nmarks99/reaction-wheel/README.md

# Reaction Wheel Project
This project was started to fullfil the competition requiements of the Midwest High Power Rocketry Competition in 2019-2020, which involved controlling the roll axis of a high power rocket.
