nmarks99/reaction-wheel/RW CAD/motor and sensor assem.SLDASM

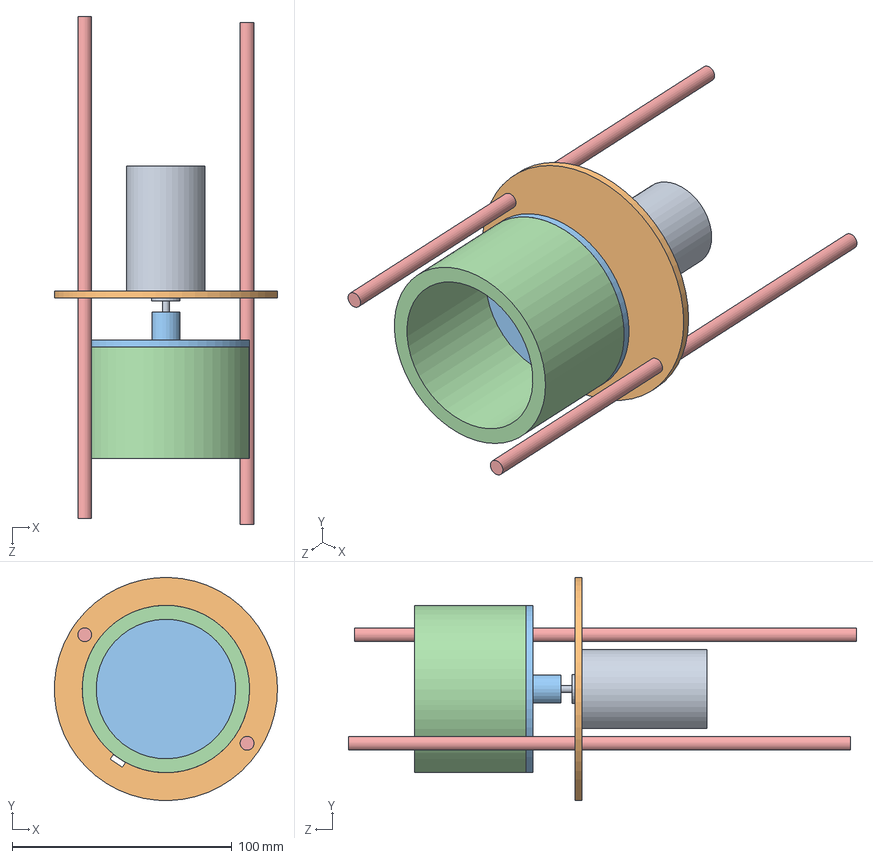
[picture p16: CAD file, 2021-04-07, last stored version]
RW CAD/motor and sensor assem.SLDASM
101.5 x 101.6 x 231.3 mm
mabuchi motor
motor disk
motor shaft coupler
rotating mass
0.25-20 threaded rod x 2
