nmarks99/reaction-wheel/RW CAD/0.25-20 threaded rod.SLDPRT

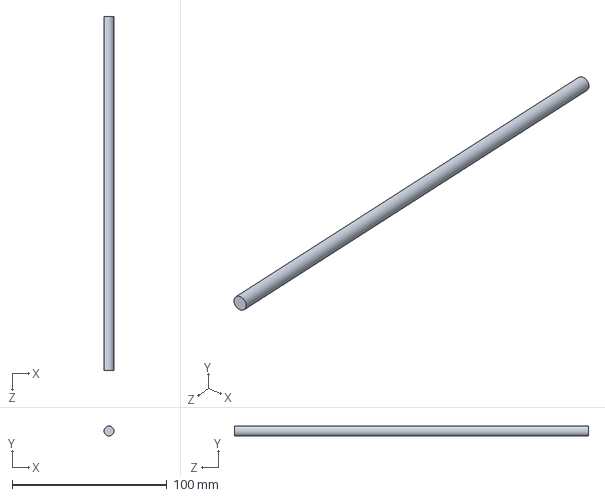
[picture p17: CAD file, 2021-04-07, last stored version]
RW CAD/0.25-20 threaded rod.SLDPRT
6.35 x 6.35 x 228.6 mm
