nmarks99/reaction-wheel/RW CAD/photo interruptor.SLDPRT

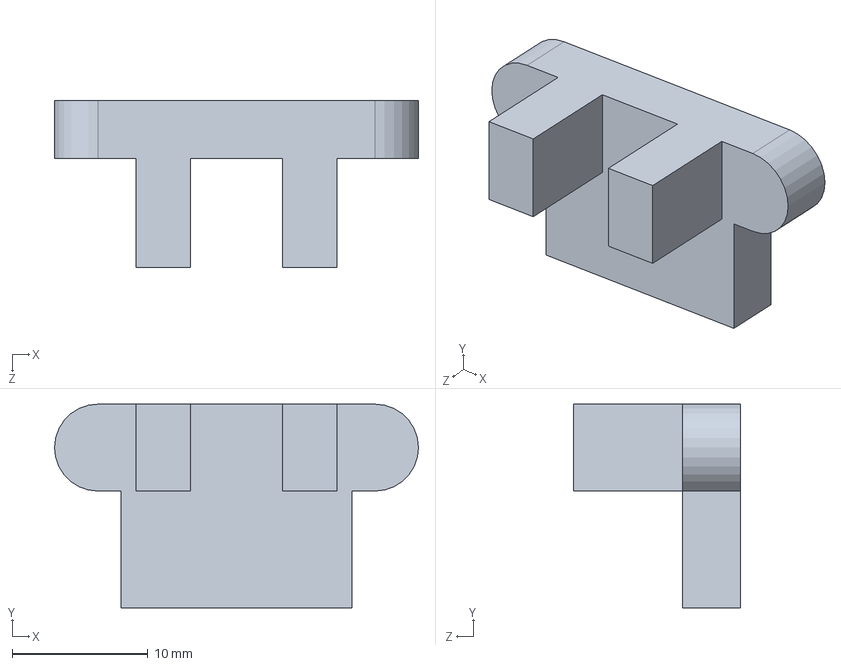
[picture p18: CAD file, 2021-04-07, last stored version]
RW CAD/photo interruptor.SLDPRT
26.8 x 15.0 x 12.3 mm
