nmarks99/reaction-wheel/RW CAD/motor holder.SLDPRT

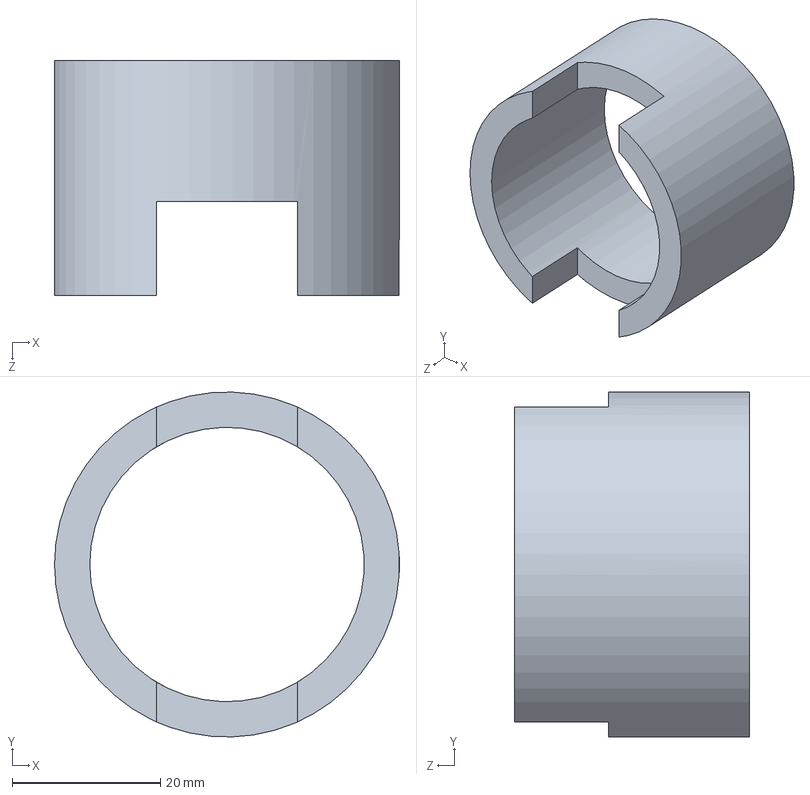
[picture p19: CAD file, 2021-04-07, last stored version]
RW CAD/motor holder.SLDPRT
46.5 x 46.5 x 31.8 mm
