nmarks99/reaction-wheel/RW CAD/motorholder top plate.STL

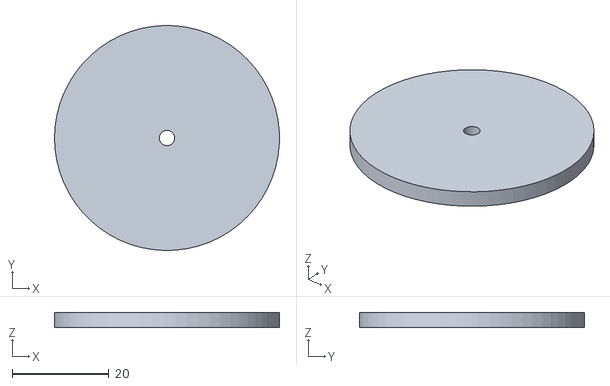
[picture p20: CAD file, 2021-04-07, last stored version]
RW CAD/motorholder top plate.STL
46.5 x 46.5 x 3.17
