nmarks99/reaction-wheel/RW CAD/electronics tray.STL

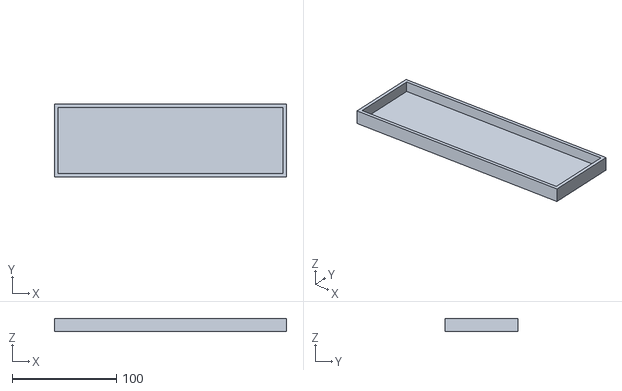
[picture p21: CAD file, 2021-04-07, last stored version]
RW CAD/electronics tray.STL
222.2 x 69.8 x 12.7
