nmarks99/reaction-wheel/RW CAD/motor disk.SLDPRT

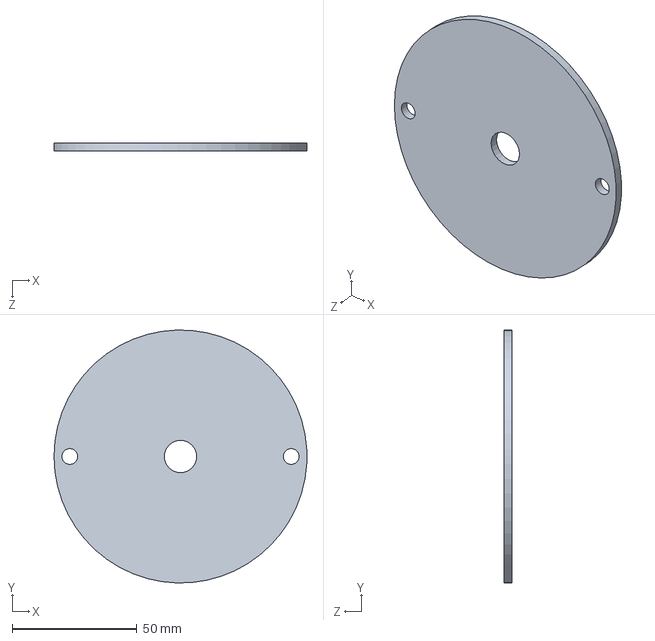
[picture p22: CAD file, 2021-04-07, last stored version]
RW CAD/motor disk.SLDPRT
101.6 x 101.6 x 3.17 mm
