nmarks99/reaction-wheel/RW CAD/electronics tray bottom.SLDPRT

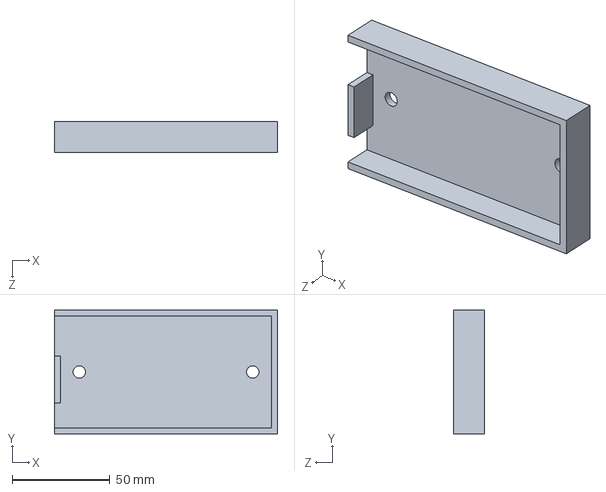
[picture p23: CAD file, 2021-04-07, last stored version]
RW CAD/electronics tray bottom.SLDPRT
114.3 x 63.5 x 15.9 mm
