nmarks99/reaction-wheel/RW CAD/sensor holder.SLDPRT

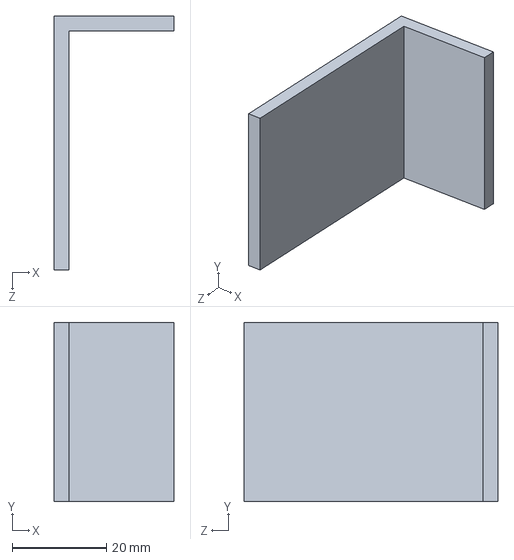
[picture p24: CAD file, 2021-04-07, last stored version]
RW CAD/sensor holder.SLDPRT
25.4 x 38.1 x 54.0 mm
