nmarks99/reaction-wheel/RW CAD/centeringring.STL

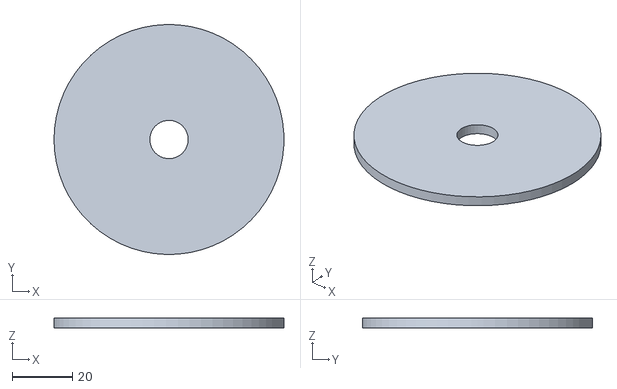
[picture p25: CAD file, 2021-04-07, last stored version]
RW CAD/centeringring.STL
76.2 x 76.2 x 3.17
