nmarks99/reaction-wheel/RW CAD/motor shaft coupler.SLDPRT

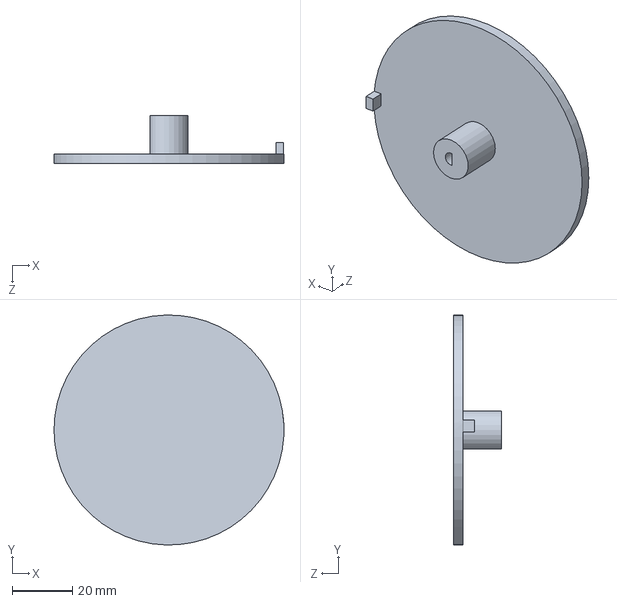
[picture p26: CAD file, 2021-04-07, last stored version]
RW CAD/motor shaft coupler.SLDPRT
76.2 x 76.2 x 15.9 mm
