nmarks99/reaction-wheel/RW CAD/rotating mass.SLDPRT

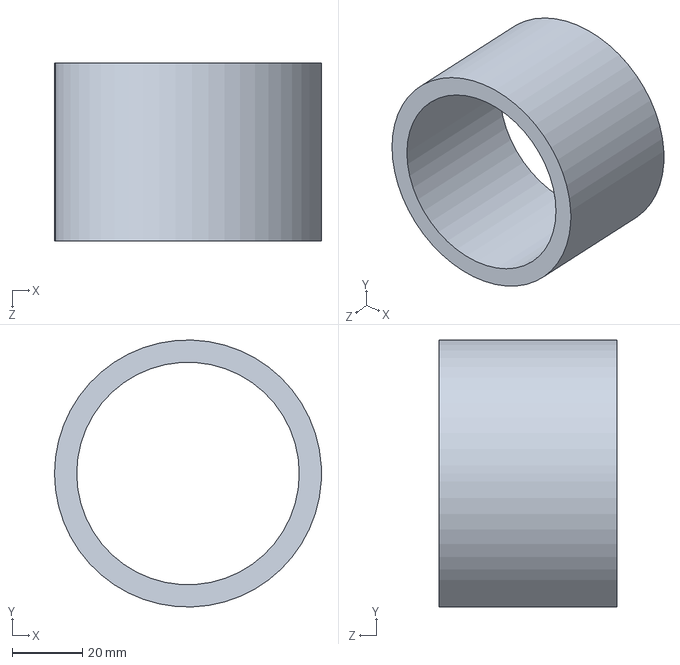
[picture p27: CAD file, 2021-04-07, last stored version]
RW CAD/rotating mass.SLDPRT
76.2 x 76.2 x 50.8 mm
