nmarks99/reaction-wheel/RW CAD/mabuchi motor.SLDPRT

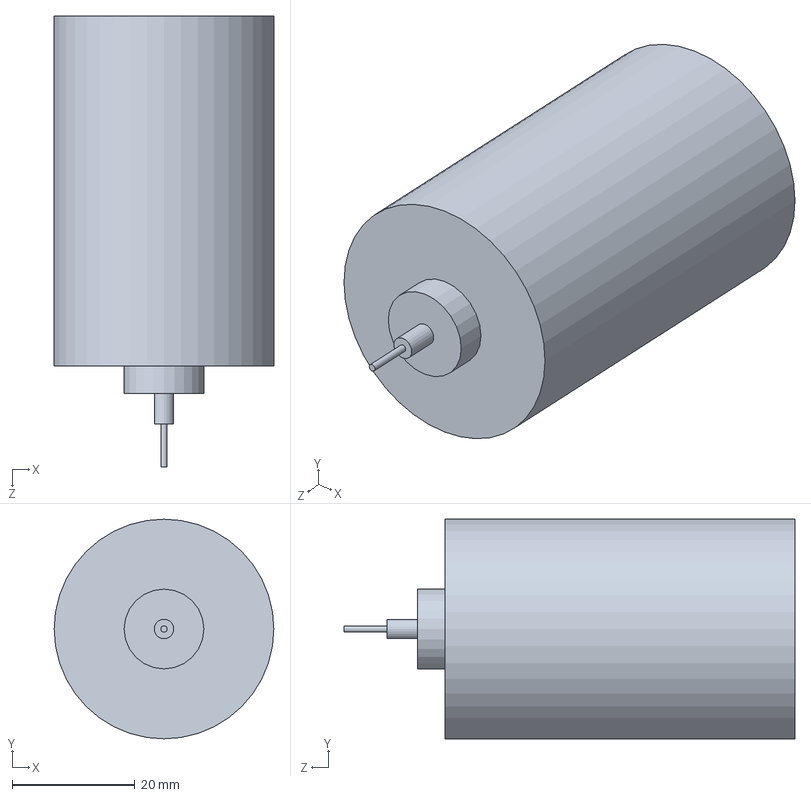
[picture p28: CAD file, 2021-04-07, last stored version]
RW CAD/mabuchi motor.SLDPRT
35.8 x 35.8 x 73.5 mm
