nmarks99/reaction-wheel/(list of files, cad)

Other CAD files:
RW CAD/electronics tray top.SLDPRT
RW CAD/centering.SLDPRT
RW CAD/electronics tray bottom.SLDDRW
RW CAD/electronics tray bottom.STL
RW CAD/electronics tray top.SLDDRW
RW CAD/electronics tray top.STL
RW CAD/motor disk.SLDDRW
RW CAD/motor disk.STL
RW CAD/motor holder.STL
RW CAD/motor shaft coupler.STL
RW CAD/sensor holder.STL
