nmarks99/reaction-wheel/Analysis/results_plots/data1.jpg

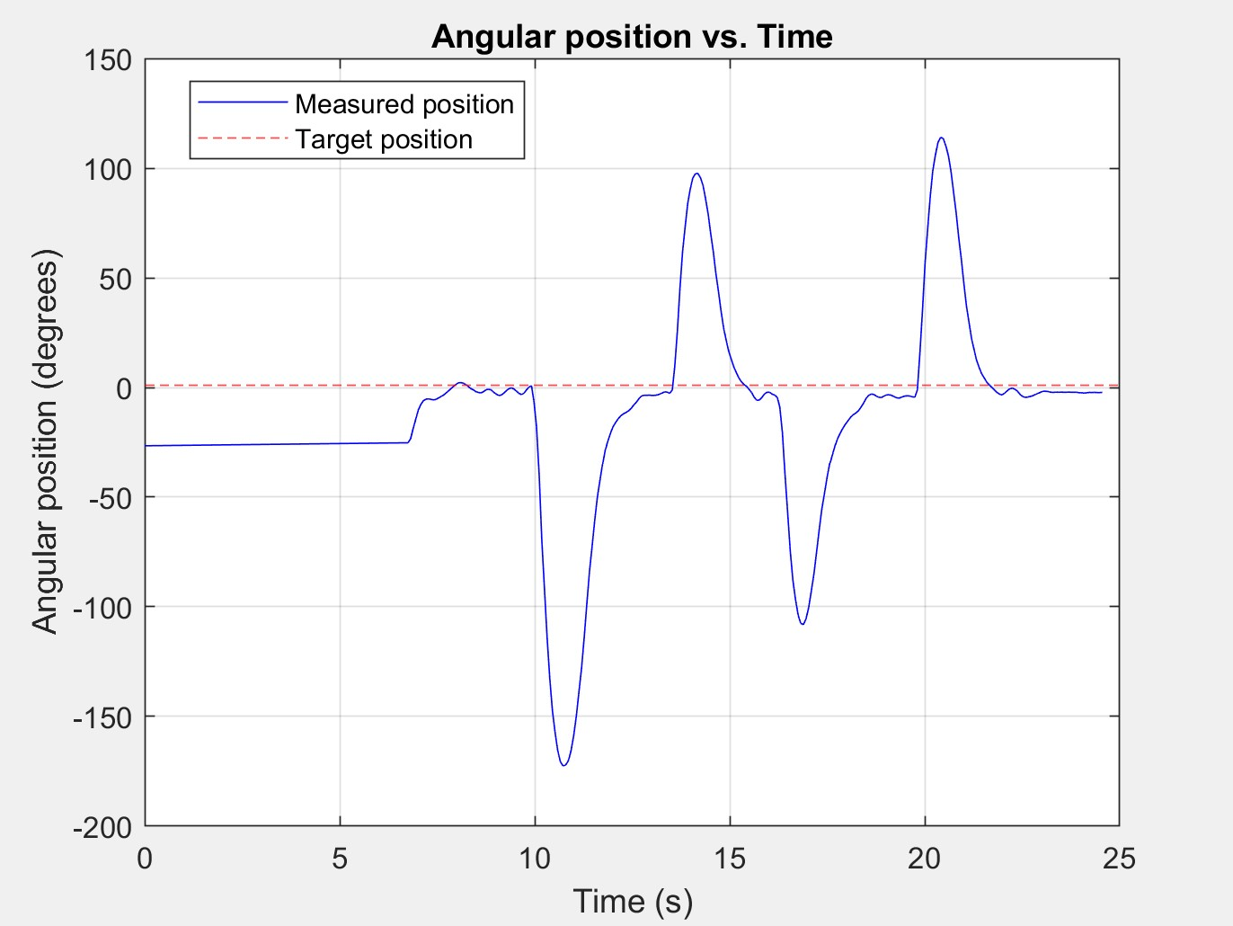
Analysis/results_plots/data1.jpg
