nmarks99/reaction-wheel/Analysis/results_plots/good1.jpg

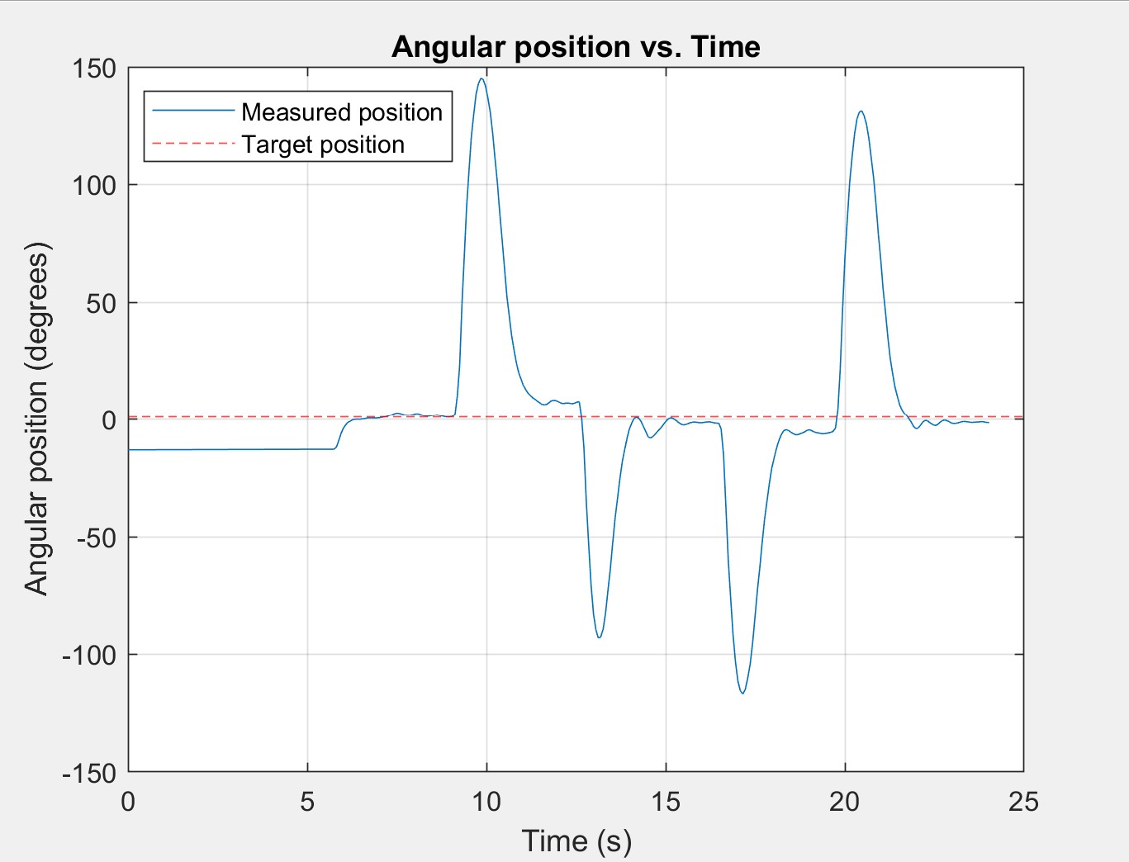
Analysis/results_plots/good1.jpg
