nmarks99/reaction-wheel/Analysis/results_plots/good2.jpg

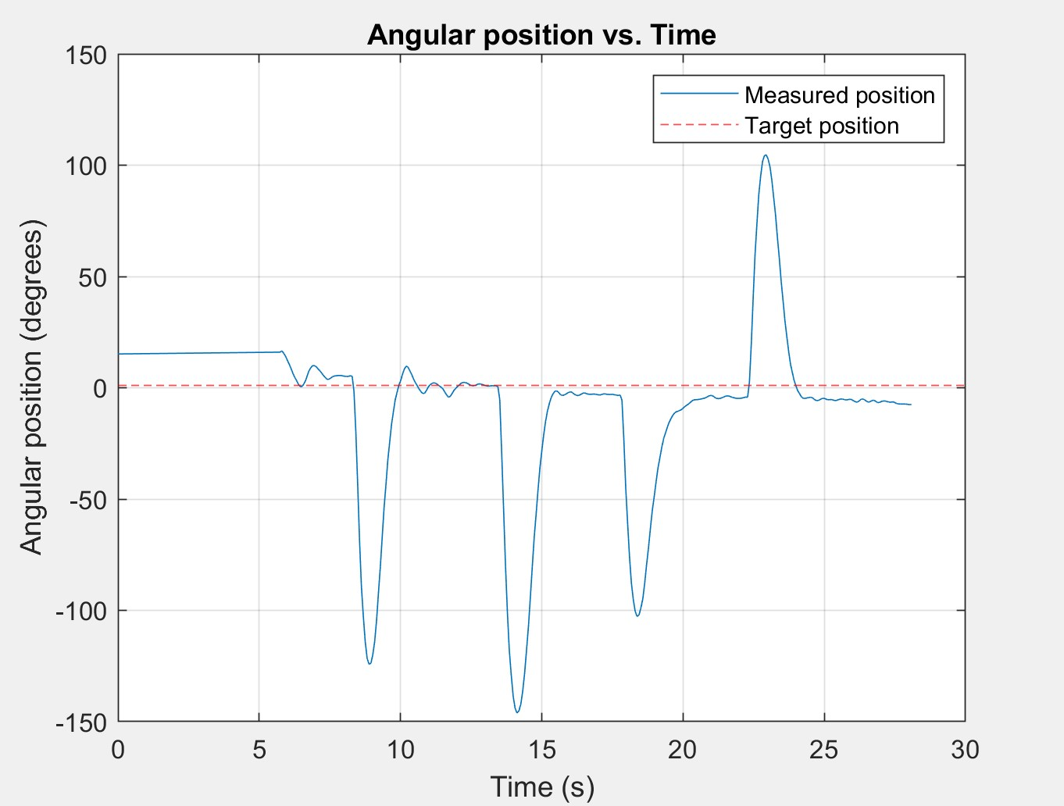
Analysis/results_plots/good2.jpg
