nmarks99/reaction-wheel/Analysis/results_plots/justone2.jpg

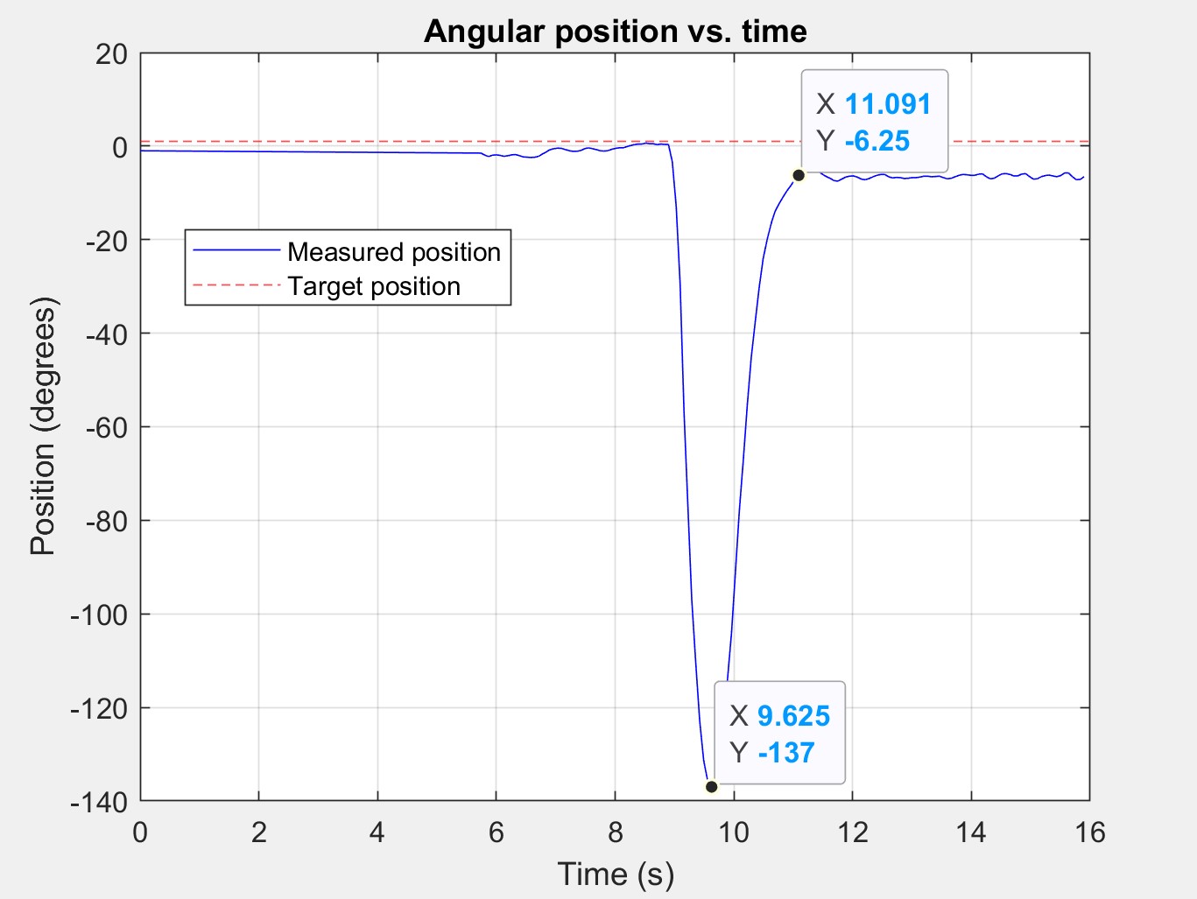
Analysis/results_plots/justone2.jpg
