nmarks99/reaction-wheel/Analysis/results_plots/tune2.jpg

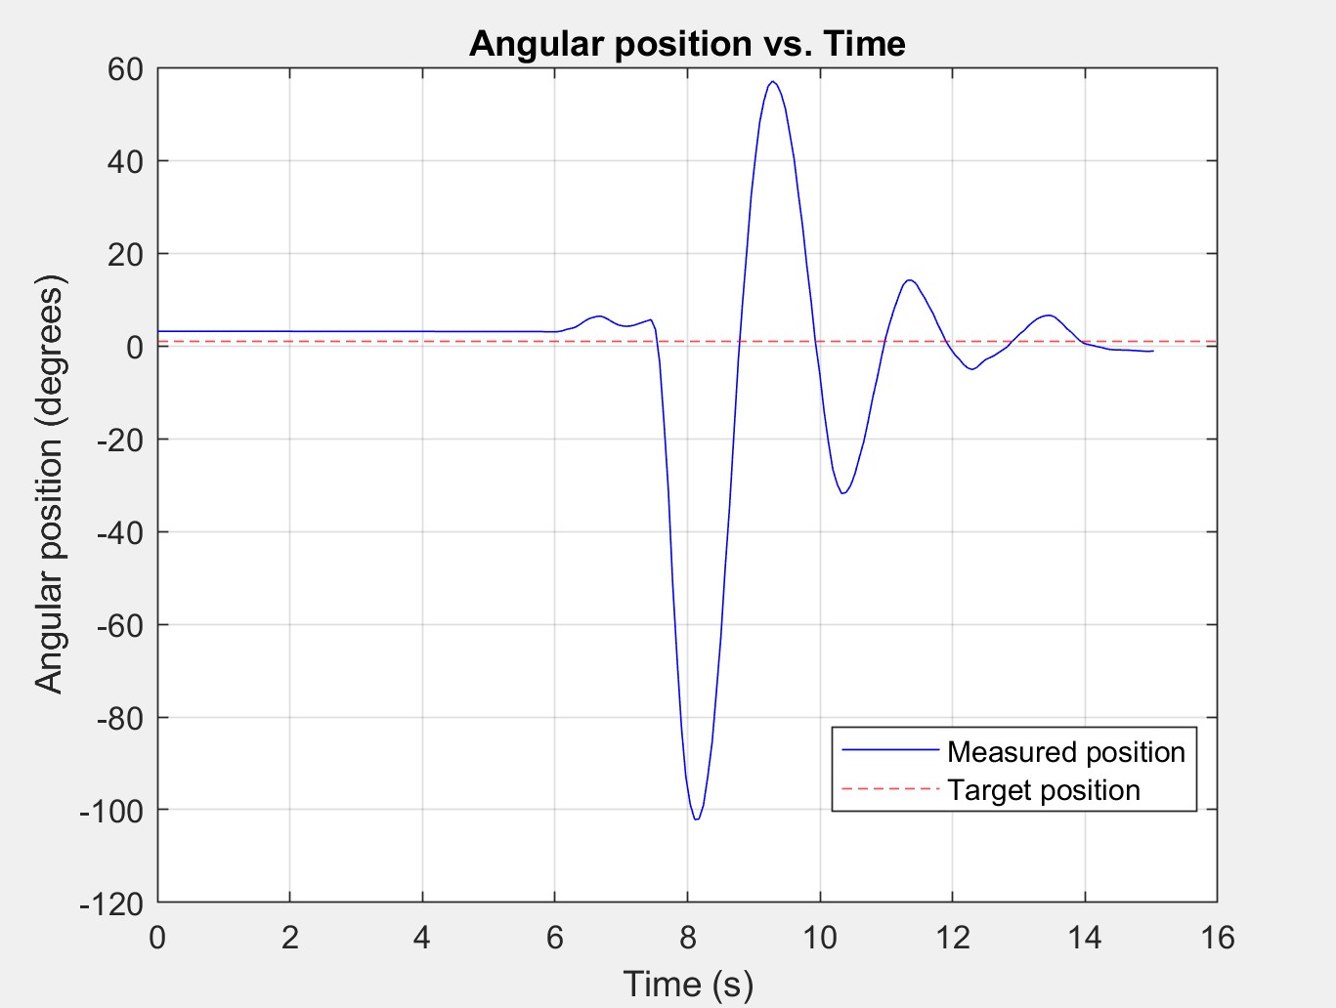
Analysis/results_plots/tune2.jpg
