nmarks99/reaction-wheel/Analysis/results_plots/tune3.jpg

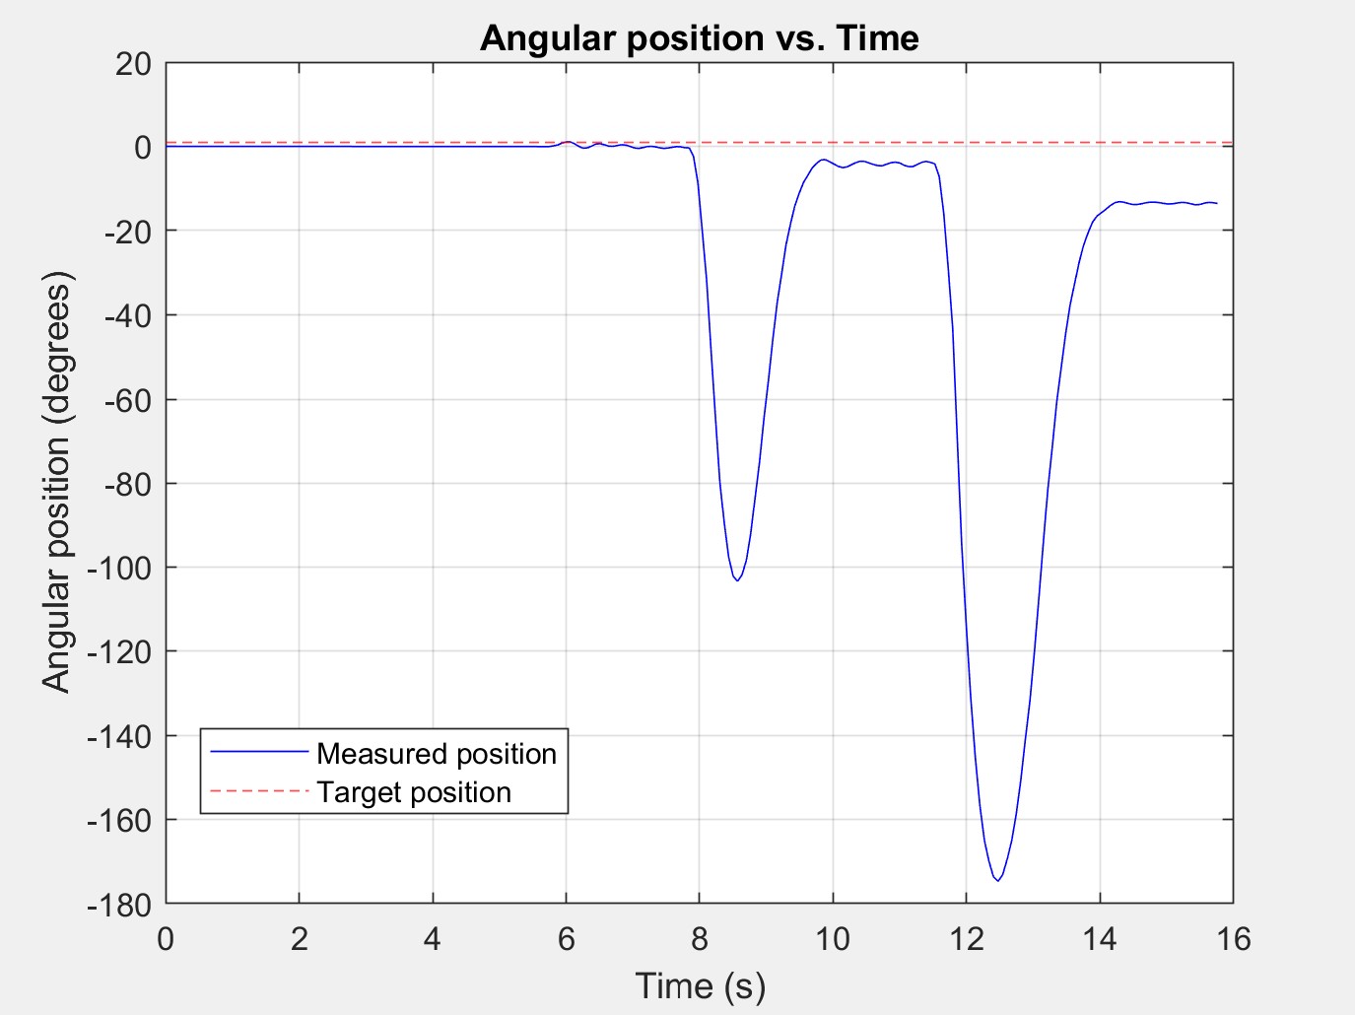
Analysis/results_plots/tune3.jpg
