nmarks99/reaction-wheel/(commit log)

2021-04-07 Added and sorted everything from my PC
    [0.25-20 threaded rod.SLDPRT, centering.SLDPRT, centeringring.STL, electronics tray bottom.SLDDRW, electronics tray bottom.SLDPRT, electronics tray bottom.STL, electronics tray top.SLDDRW, electronics tray top.SLDPRT]
2021-09-30 OLD contains working .ino file, reaction-wheel is pio proj
